ssam-lll/idline-esp32/docs/assets/regulador_mini360_trasera.png

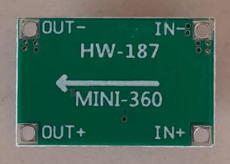
docs/assets/regulador_mini360_trasera.png
