ssam-lll/idline-esp32/docs/assets/esp32_devkit_v1_trasera.png

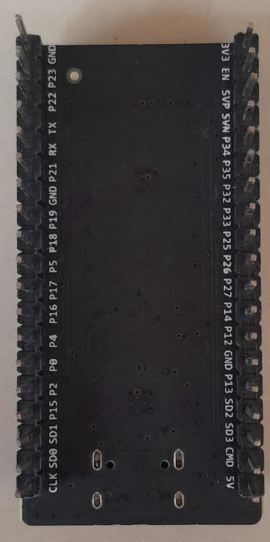
docs/assets/esp32_devkit_v1_trasera.png
