ssam-lll/idline-esp32/reference/README.md

# Referencias Externas

Este directorio almacena proyectos o repositorios de referencia.

- **IDLine Original (ESP32-C3 / ESP32-S2):**
  - Repositorio oficial: [https://github.com/idrsldev/IDLine](https://github.com/idrsldev/IDLine)
  - Clonar localmente si se requiere inspección:
    ```bash
    git clone https://github.com/idrsldev/IDLine.git reference/idline_original
    ```
