ssam-lll/idline-esp32/docs/assets/baterias_18650_samsung_30q.png

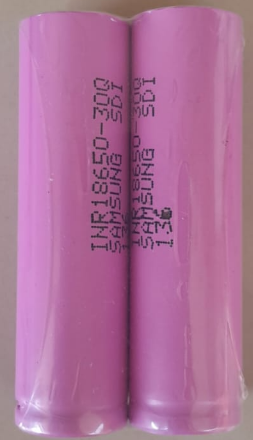
docs/assets/baterias_18650_samsung_30q.png
