ssam-lll/idline-esp32/docs/assets/driver_tb6612fng_frontal.png

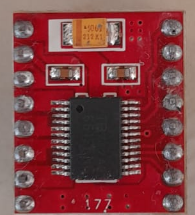
docs/assets/driver_tb6612fng_frontal.png
