ssam-lll/idline-esp32/docs/assets/driver_tb6612fng_trasera.png

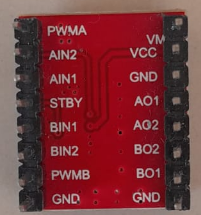
docs/assets/driver_tb6612fng_trasera.png
