ssam-lll/idline-esp32/docs/assets/esp32_devkit_v1_frontal.png

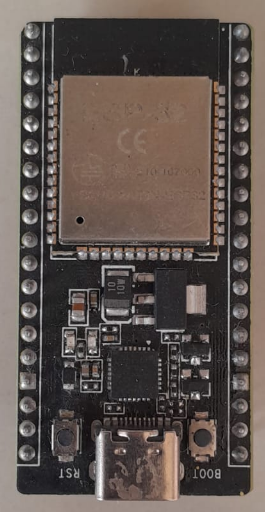
docs/assets/esp32_devkit_v1_frontal.png
