ssam-lll/idline-esp32/docs/assets/micromotores_n20.png

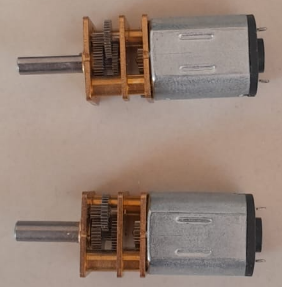
docs/assets/micromotores_n20.png
