ssam-lll/idline-esp32/docs/assets/multiplexor_cd74hc4067.png

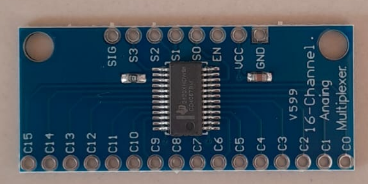
docs/assets/multiplexor_cd74hc4067.png
