ssam-lll/idline-esp32/docs/assets/pantalla_tft_1_54_frontal.png

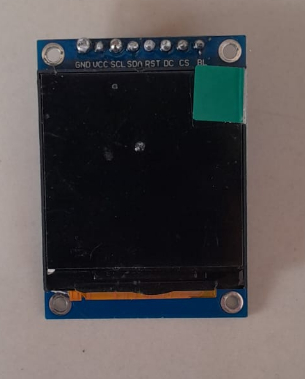
docs/assets/pantalla_tft_1_54_frontal.png
