ssam-lll/idline-esp32/docs/assets/pantalla_tft_1_54_trasera.png

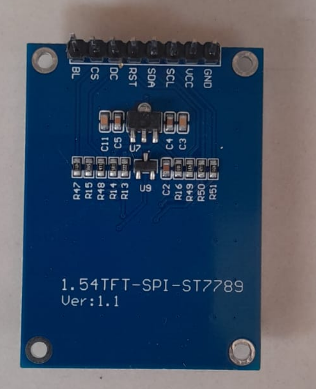
docs/assets/pantalla_tft_1_54_trasera.png
