ssam-lll/idline-esp32/docs/assets/pulsador_tactil_2pin.png

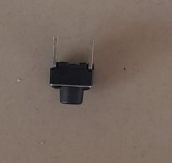
docs/assets/pulsador_tactil_2pin.png
