ssam-lll/idline-esp32/docs/assets/regulador_mini360_frontal.png

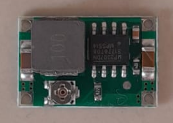
docs/assets/regulador_mini360_frontal.png
