ssam-lll/idline-esp32/tools/pista_dibujo_samuel.png

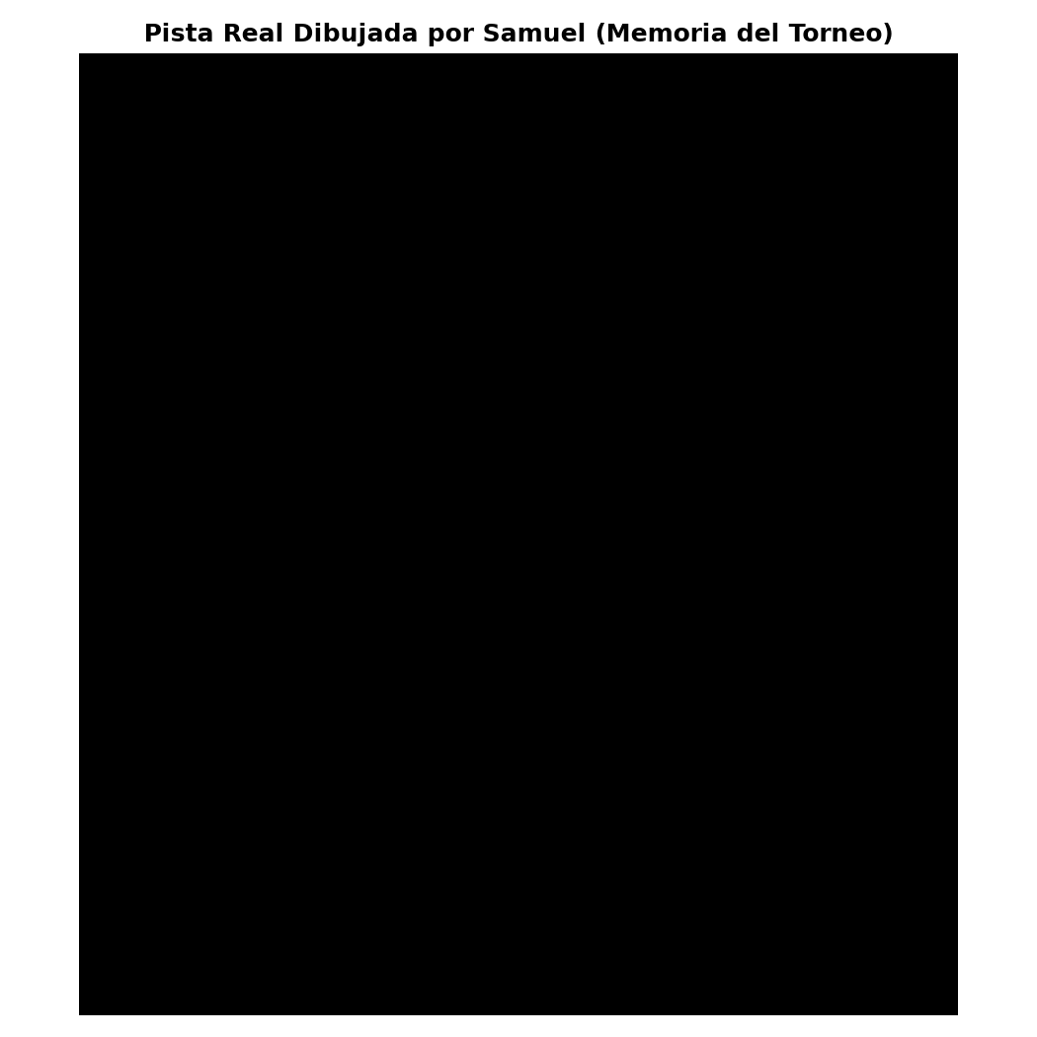
tools/pista_dibujo_samuel.png
