ssam-lll/idline-esp32/hardware/stl_impresion/3_Cajon_Baterias_2S.stl

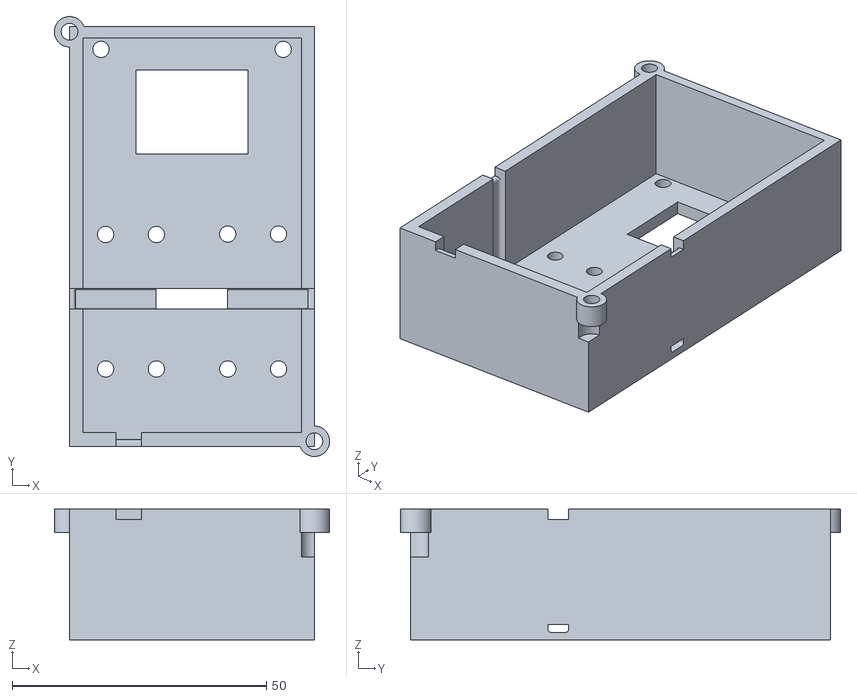
[picture p14: CAD file, 2026-11-05]
hardware/stl_impresion/3_Cajon_Baterias_2S.stl
54.1 x 86.4 x 25.7
