ssam-lll/idline-esp32/hardware/stl_impresion/4_Bandeja_Placa_Madre_109x59.stl

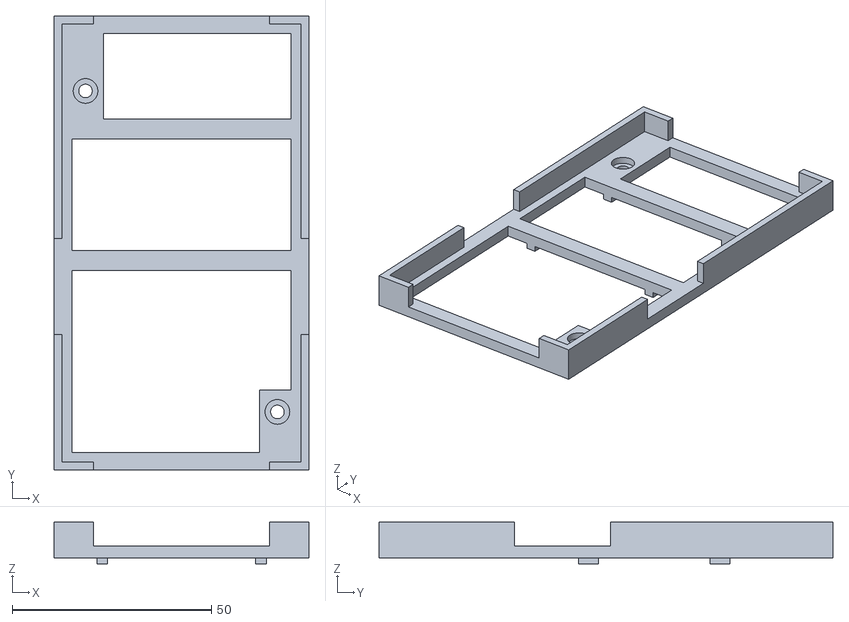
[picture p15: CAD file, 2026-11-05]
hardware/stl_impresion/4_Bandeja_Placa_Madre_109x59.stl
63.8 x 113.8 x 10.5
