ssam-lll/idline-esp32/hardware/stl_impresion/1_Base_Inferior_Motores.stl

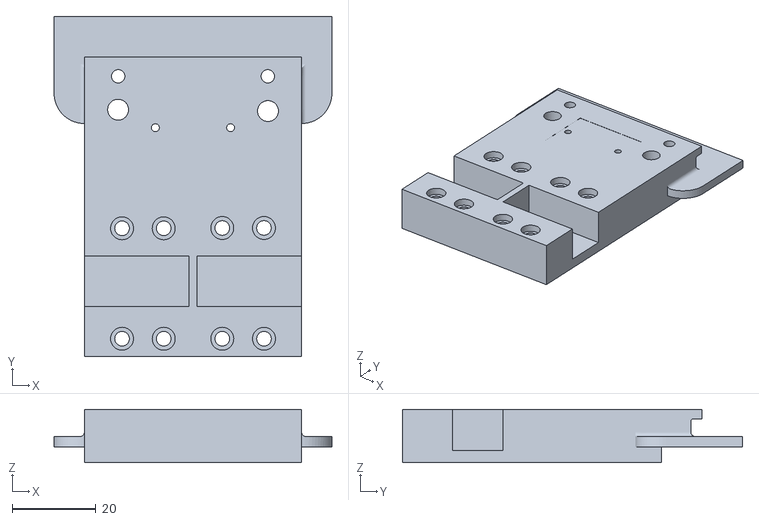
[picture p16: CAD file, 2026-11-05]
hardware/stl_impresion/1_Base_Inferior_Motores.stl
66.5 x 81.4 x 12.8
