ssam-lll/idline-esp32/hardware/stl_impresion/2_Soporte_Frontal_Sensores.stl

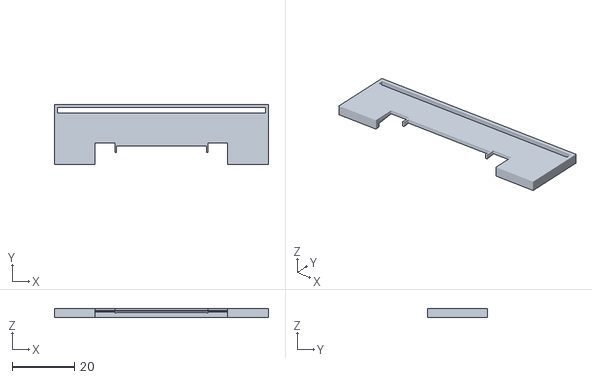
[picture p17: CAD file, 2026-11-05]
hardware/stl_impresion/2_Soporte_Frontal_Sensores.stl
69.0 x 19.5 x 2.85
