ssam-lll/idline-esp32/(list of files, cad)

Other CAD files:
hardware/Chasis_Adaptado.f3d
