ssam-lll/idline-esp32/tools/reconstruccion_pista_real.png

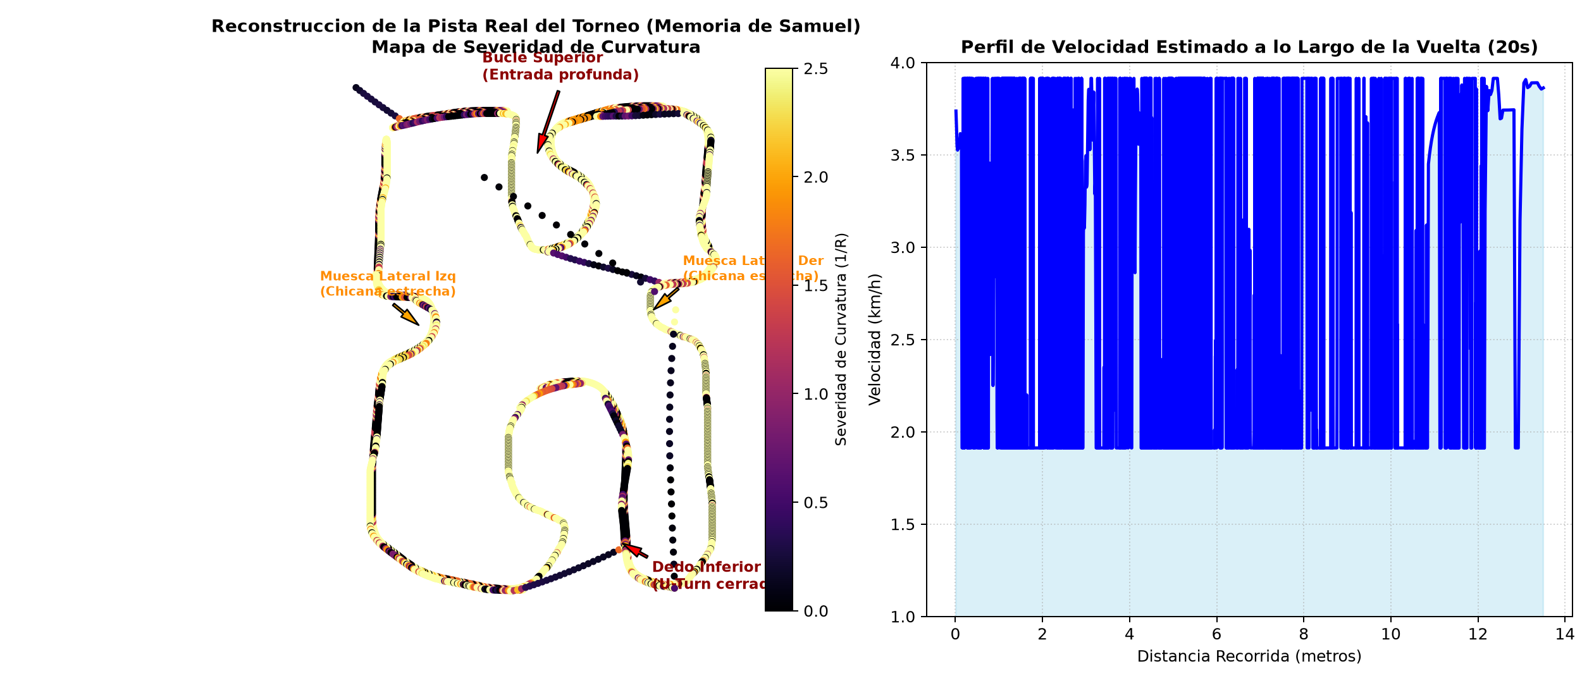
tools/reconstruccion_pista_real.png
