ssam-lll/idline-esp32/(list of files, drawings)

Other design files:
hardware/esquematico/SCH_IDLine_2026-10-12.json
