ssam-lll/idline-esp32/(commit log)

2026-10-13 feat: estructura inicial del seguidor de línea (documentación, esquemático y guías de ensamble)
    [SCH_IDLine_2026-10-12.json]
2026-11-05 feat: add ESP32 firmware, STL chassis files, and MQTT test scripts
    [1_Base_Inferior_Motores.stl, 2_Soporte_Frontal_Sensores.stl, 3_Cajon_Baterias_2S.stl, 4_Bandeja_Placa_Madre_109x59.stl, Chasis_Adaptado.f3d]
2026-11-05 fix(pid): normalize derivative dt_ms scaling and tune base_speed/kp for floor traction
    [main.cpp, types.h]
2026-11-05 fix(sensor): reverse channel order from C4..C11 to C11..C4 to match physical layout
2026-11-05 fix(motor): remove debug GPIO loop in pantalla.cpp that hijacked GPIO17 (PWMB) into permanent HIGH
    [main.cpp, types.h]
2026-11-06 feat: optimize high-speed PID profile and add tournament autonomous features
2026-11-06 fix(tft): initialize pantalla before telemetria and avoid WiFi.mode(WIFI_OFF) panic on boot
    [main.cpp]
2026-11-06 revert: restore rock-solid 154c7ca base with tuned high-speed PID (base_speed=680, Kp=0.38, Kd=4.0)
    [main.cpp, types.h]
2026-11-08 Revert "revert: restore rock-solid 154c7ca base with tuned high-speed PID (base_speed=680, Kp=0.38, Kd=4.0)"
    This reverts commit 0ac62ebd3c3846fbd756c547bd32d1454345a0a1.
    [main.cpp, types.h]
2026-11-08 feat: add mobile web dashboard and real track reconstruction from Samuel's drawing
